hubbellc/Oscillating-Air-Engine/Engine Complete.jpg

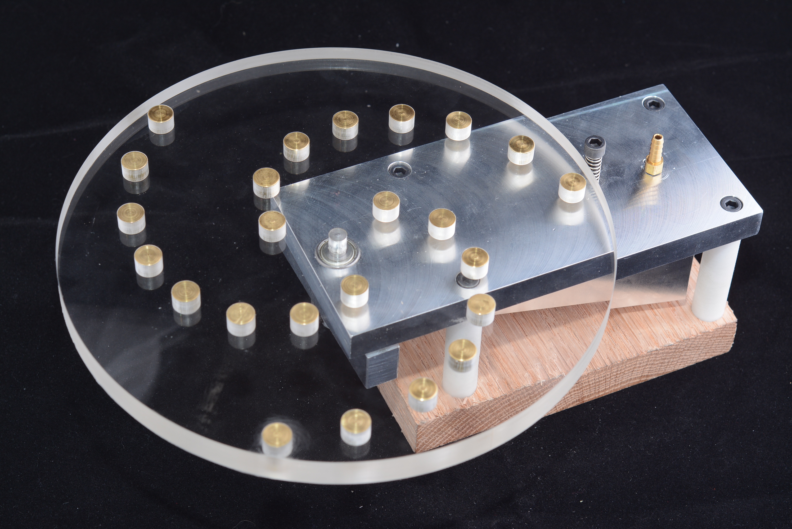
Engine Complete.jpg
