hubbellc/Oscillating-Air-Engine/Engine Facts.pdf

# The Enterprise – By Caleb Hubbell

# Facts Sheet

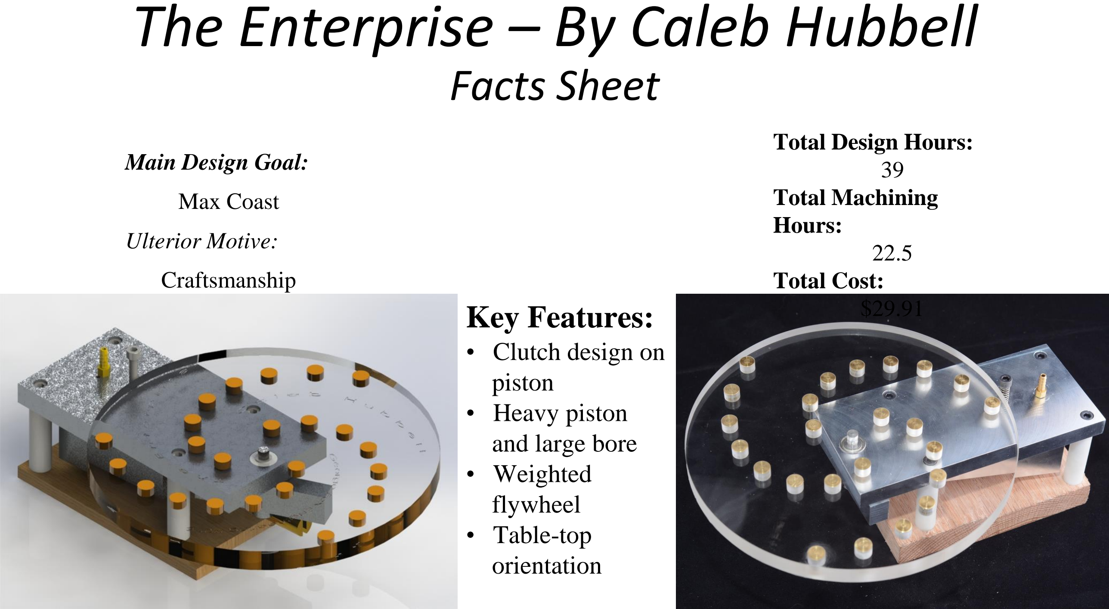
[picture p3: page 1]

Main Design Goal:

Max Coast

Ulterior Motive:

Craftsmanship

## Key Features:

- Clutch design on
piston
- Heavy piston
and large bore
- Weighted
flywheel
- Table-top
orientation

Total Design Hours:
39
Total Machining
Hours:
22.5
Total Cost:
$29.91
