hubbellc/Oscillating-Air-Engine/Engine Comp.jpg

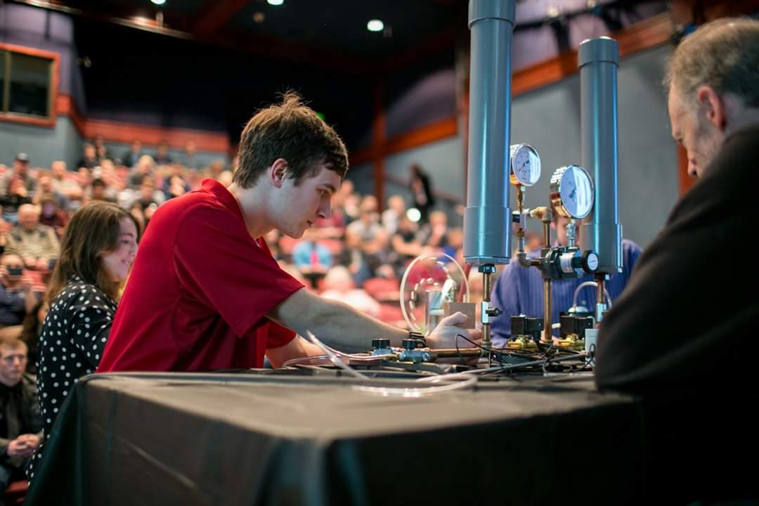
Engine Comp.jpg
