hubbellc/Oscillating-Air-Engine/Engine Flywheel Cut.jpg

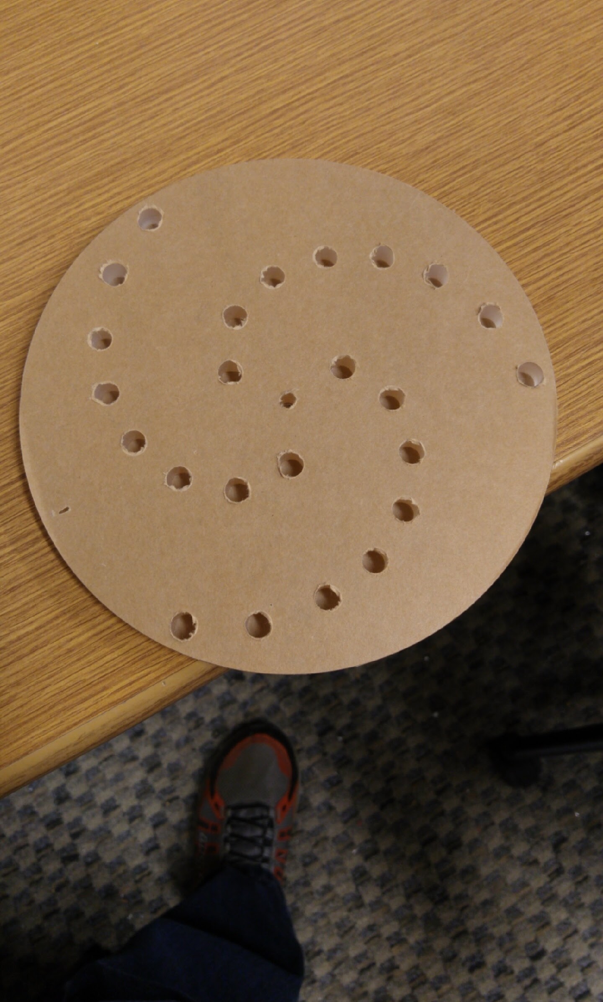
Engine Flywheel Cut.jpg
