hubbellc/Oscillating-Air-Engine/Engine Flywheel with Inserts.jpg

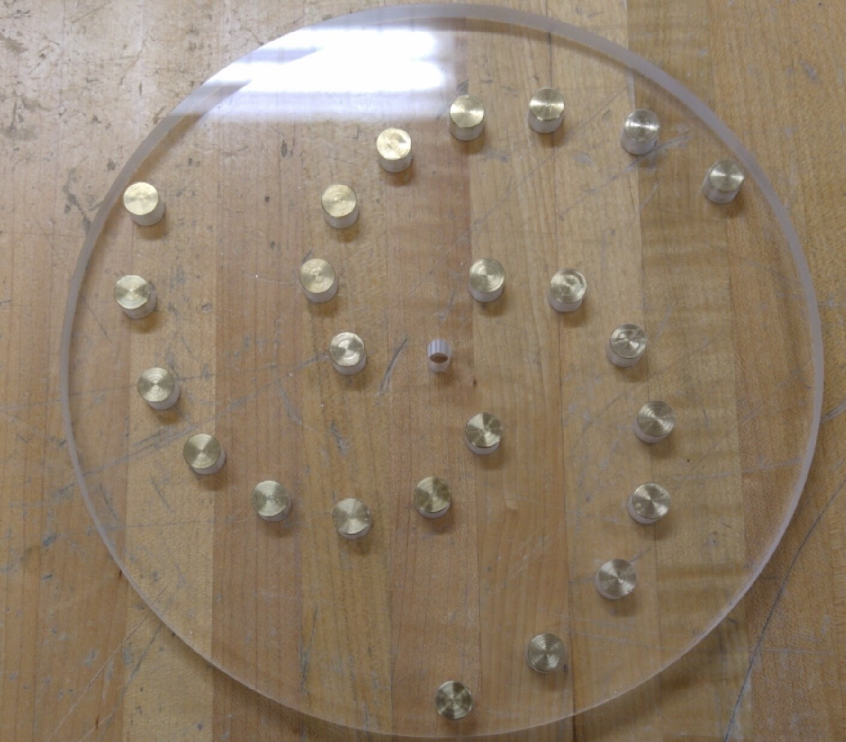
Engine Flywheel with Inserts.jpg
