hubbellc/Oscillating-Air-Engine/Engine Progress.jpg

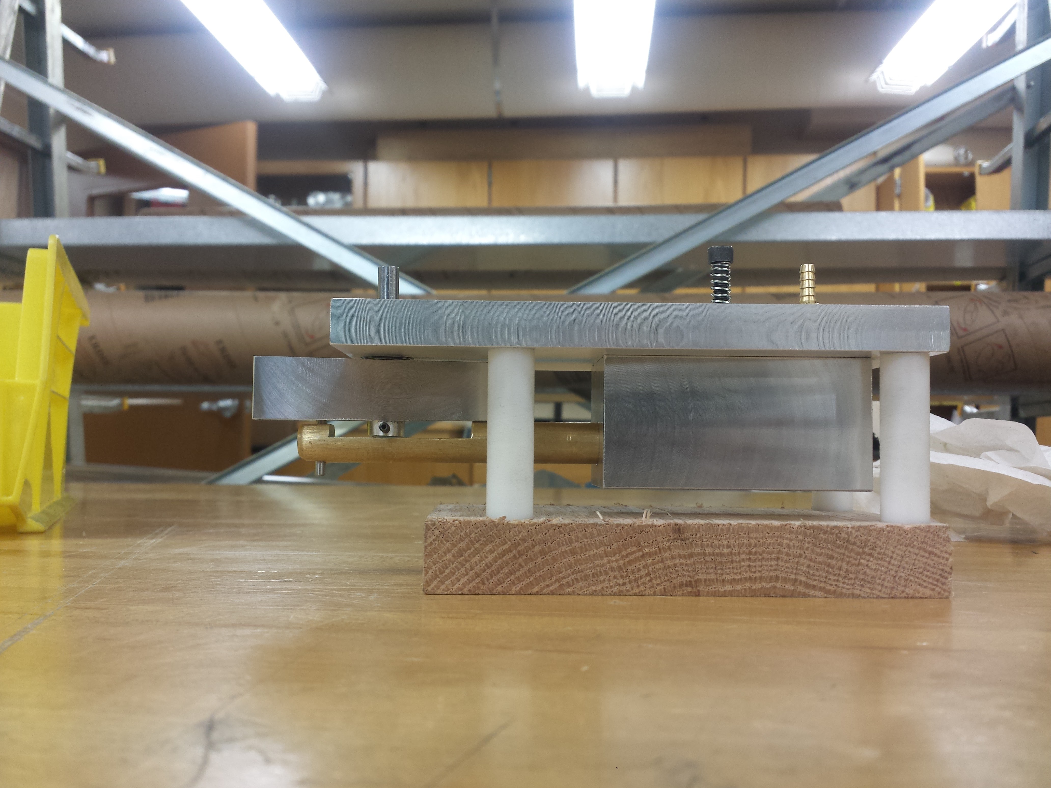
Engine Progress.jpg
