hubbellc/Oscillating-Air-Engine/Engine Bill of Materials.xlsx

 |  |  | Caleb Hubbell
 | Part Description | Stock Demension | Material | Added Length (in inches) | Cost per Unit | Quantity | Cost
1 | Legs | 1/2" | White Delrin | 2 | $0.12 | 4 | $0.96
2 | Valve Plate | ½” x 3” | Aluminum | 6.5 | $1.03 | 1 | $6.70
3 | Cylinder | 1 1/2" x 1 1/2" | Aluminum | 3 | $1.00 | 1 | $3.00
4 | Piston | 1/2” | Brass | 4.5 | $0.62 | 1 | $2.79
5 | Crank "Disc" | 1/2"x 3" | Aluminum | 0.9 | $1.03 | 1 | $0.93
6 | Crank Shaft | 1/4" | Steel | 1.952 | $0.31 | 1 | $0.61
7 | Flywheel | 1/2" | Clear Acrylic | 7.75^2 | $0.06 | 1 | $3.60
8 | Inserts | 3/8" | Brass | 0.445 | $0.38 | 24 | $4.06
9 | Base Plate | 1"x 5.5" | Oak | 3 | $0.30 | 1 | $0.90
 |  |  |  |  |  | Machined Total: | $23.54
10 | Air Inlet | 10-32 Thread |  |  | $0.96 | 1 | $0.96
11 | Bearings |  |  |  | $1.49 | 2 | $2.98
12 | Spring | 1"x.24" |  |  | $0.82 | 1 | $0.82
13 | Leg Screws | #10-32 1" |  |  | $0.16 | 4 | $0.64
14 | Cylindar Screw | #10-32 2" |  |  | $0.25 | 1 | $0.25
15 | Shim | .03 1/4in |  |  | $0.17 | 2 | $0.34
16 | Set Screw | #4-40 3/8" |  |  | $0.13 | 1 | $0.13
17 | E-Pin | 1/8" |  | 1 | $0.25 | 1 | $0.25
 |  |  |  |  |  | Purchased Total: | $6.37
 |  |  |  |  |  | Total Cost: | $29.91
