hubbellc/Oscillating-Air-Engine/Engine Design Files/Engine Take 1.SLDASM

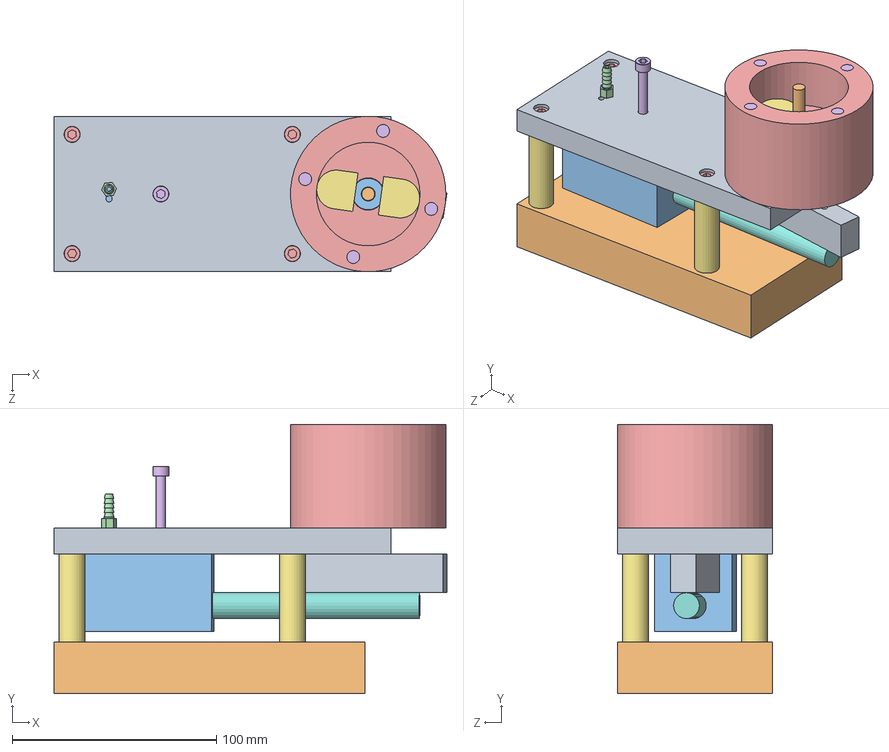
[picture p8: CAD file, 2018-04-09]
Engine Design Files/Engine Take 1.SLDASM
192.6 x 132.1 x 76.2 mm
Crank Disk
Crank Shaft
Cylindar
E-Pin
Flywheel
Inserts x 4
Legs x 4
Piston
Valve Plate
Base Plate
Ball_Bearing x 2
Barbed_Air_Inlet
SHCS_#10_x_1000 x 4
SHCS_#10_x_2000
Clutch's x 2
