hubbellc/Oscillating-Air-Engine/Engine Design Files/Engine.SLDASM

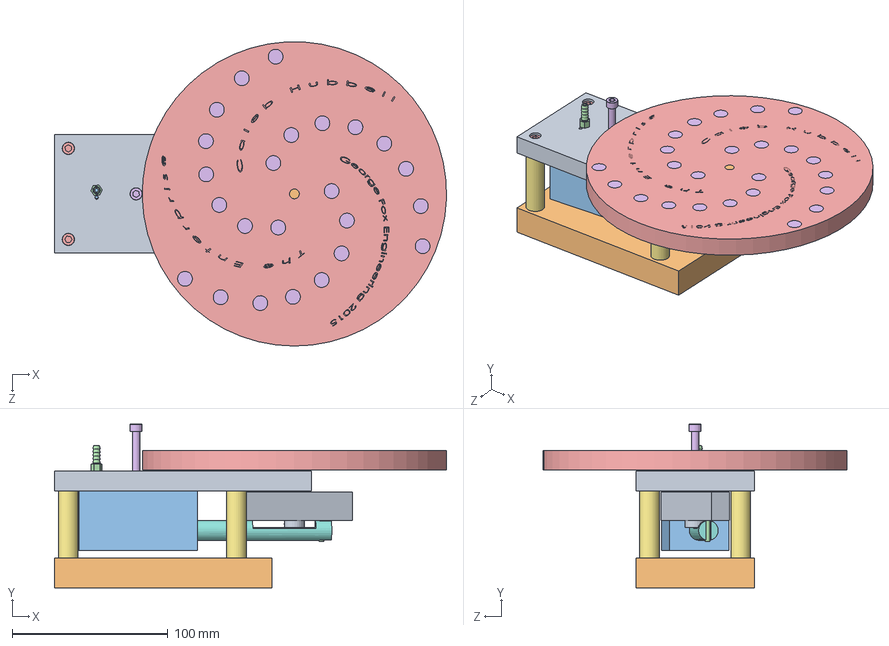
[picture p9: CAD file, 2018-04-09]
Engine Design Files/Engine.SLDASM
251.6 x 105.1 x 195.2 mm
Crank Disk
Crank Shaft
Cylindar
E-Pin
Flywheel
Inserts x 24
Legs x 4
Piston
Valve Plate
Base Plate
Ball_Bearing x 2
Barbed_Air_Inlet
SHCS_#10_x_1000 x 4
SHCS_#10_x_2000
Shim_0_030 x 2
Set_Screw_#4_x_0375
