hubbellc/Oscillating-Air-Engine/Engine Design Files/Flywheel.SLDPRT

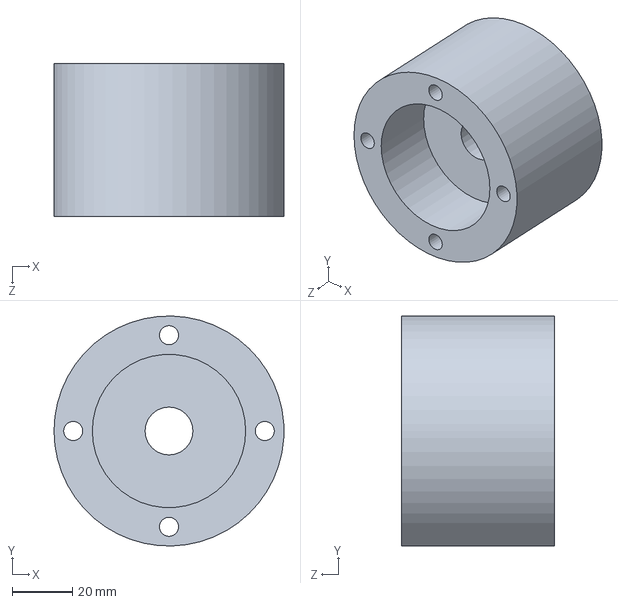
[picture p10: CAD file, 2018-04-09]
Engine Design Files/Flywheel.SLDPRT
76.2 x 76.2 x 50.8 mm
