hubbellc/Oscillating-Air-Engine/Engine Design Files/Inserts.SLDPRT

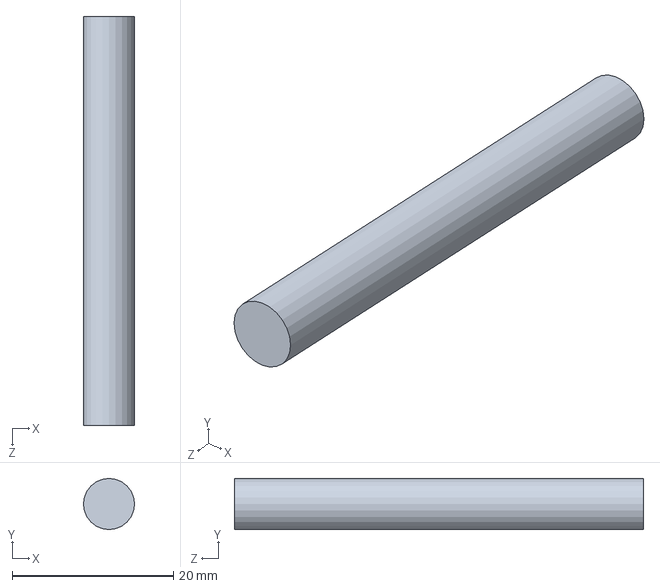
[picture p11: CAD file, 2018-04-09]
Engine Design Files/Inserts.SLDPRT
6.35 x 6.35 x 50.8 mm
