hubbellc/Oscillating-Air-Engine/Engine Design Files/Valve Plate.SLDPRT

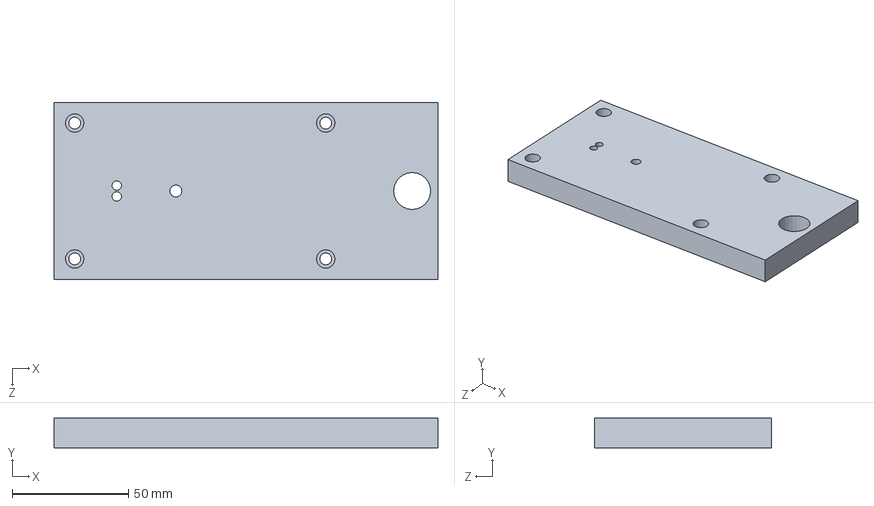
[picture p12: CAD file, 2018-04-09]
Engine Design Files/Valve Plate.SLDPRT
165.1 x 12.7 x 76.2 mm
