hubbellc/Oscillating-Air-Engine/Engine Design Files/E-Pin.SLDPRT

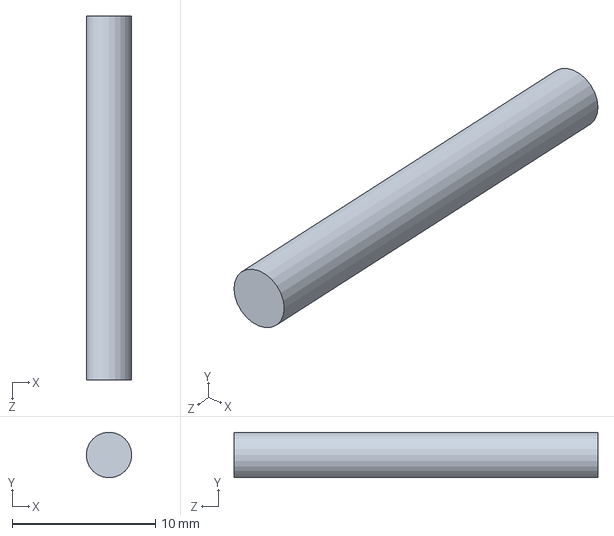
[picture p13: CAD file, 2018-04-09]
Engine Design Files/E-Pin.SLDPRT
3.18 x 3.18 x 25.4 mm
