hubbellc/Oscillating-Air-Engine/Engine Design Files/Base Plate.SLDPRT

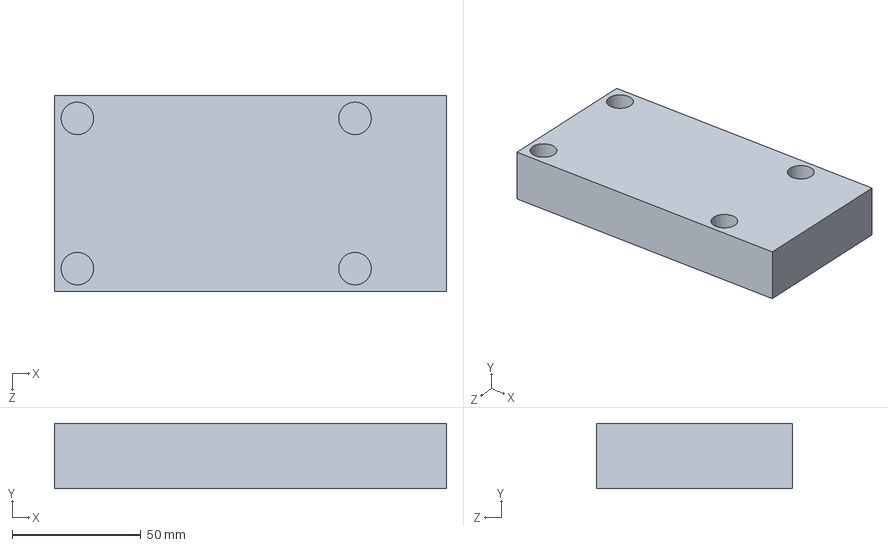
[picture p14: CAD file, 2018-04-09]
Engine Design Files/Base Plate.SLDPRT
152.4 x 25.4 x 76.2 mm
