hubbellc/Oscillating-Air-Engine/Engine Design Files/Crank Disk.SLDPRT

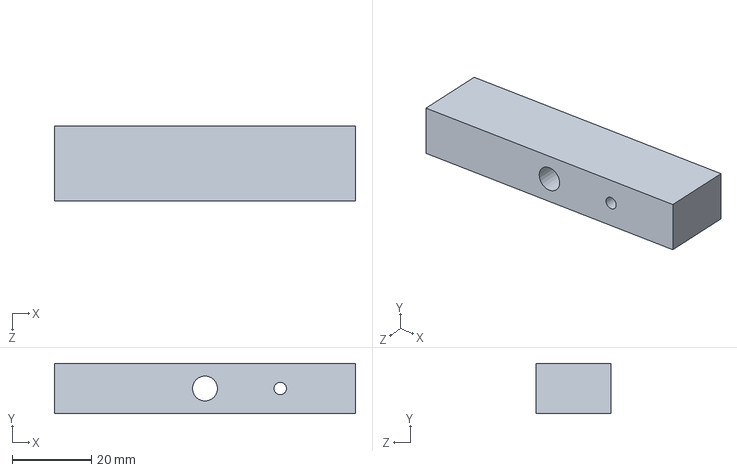
[picture p15: CAD file, 2018-04-09]
Engine Design Files/Crank Disk.SLDPRT
76.2 x 12.7 x 19.1 mm
