hubbellc/Oscillating-Air-Engine/Engine Design Files/Piston.SLDPRT

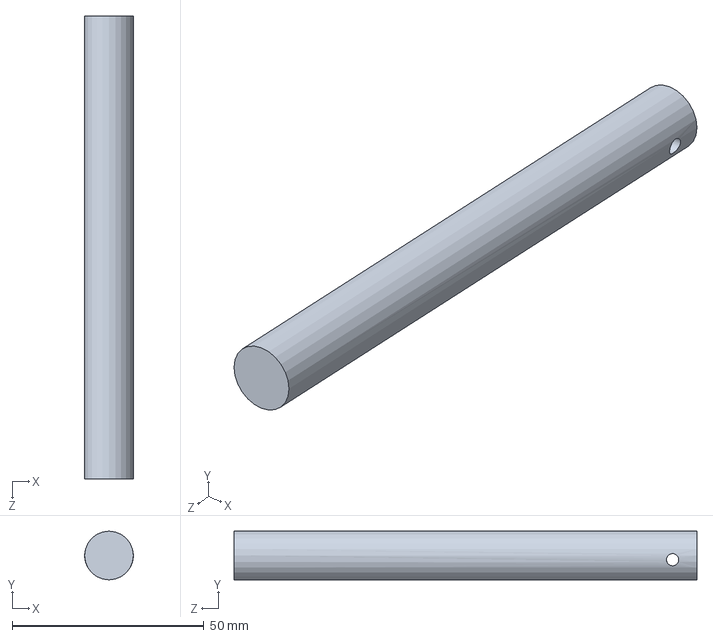
[picture p16: CAD file, 2018-04-09]
Engine Design Files/Piston.SLDPRT
12.7 x 12.7 x 120.7 mm
