hubbellc/Oscillating-Air-Engine/Engine Design Files/Clutch's.SLDPRT

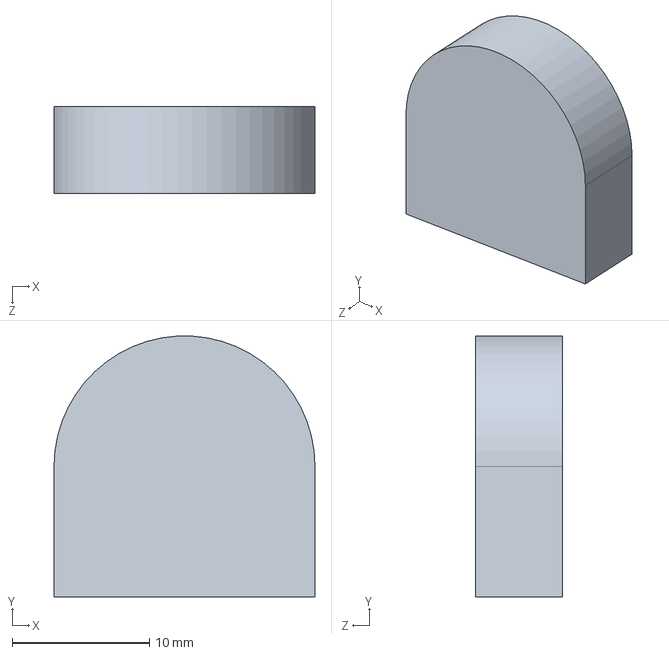
[picture p17: CAD file, 2018-04-09]
Engine Design Files/Clutch's.SLDPRT
19.1 x 19.0 x 6.35 mm
