hubbellc/Oscillating-Air-Engine/Engine Design Files/Crank Shaft.SLDPRT

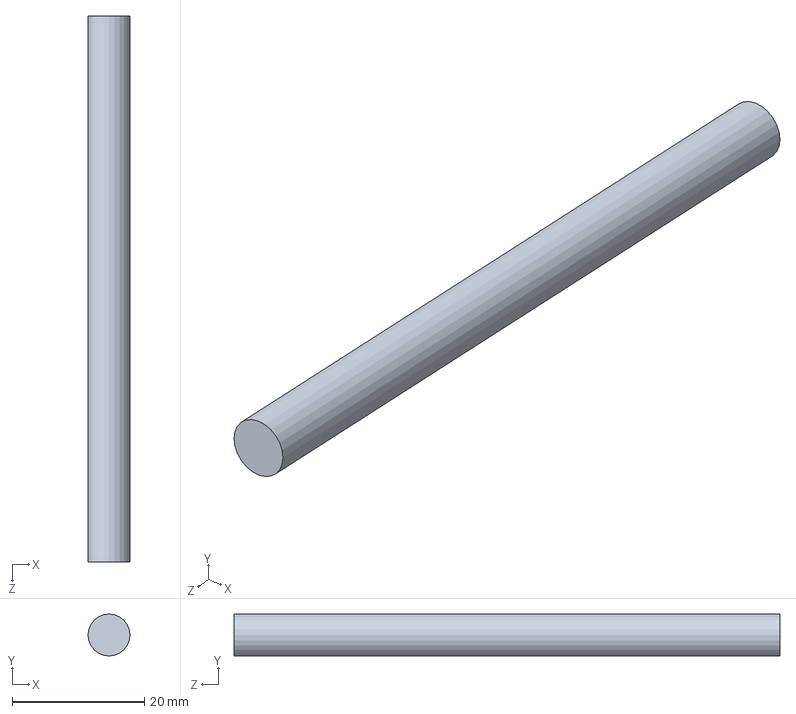
[picture p18: CAD file, 2018-04-09]
Engine Design Files/Crank Shaft.SLDPRT
6.35 x 6.35 x 82.5 mm
