hubbellc/Oscillating-Air-Engine/Engine Design Files/Legs.SLDPRT

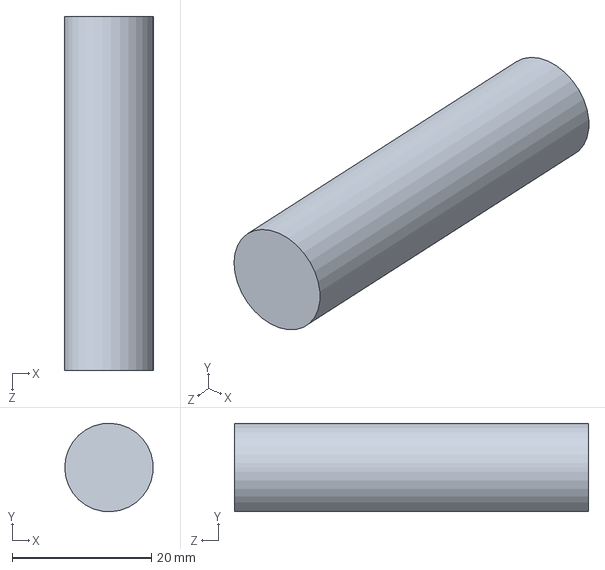
[picture p19: CAD file, 2018-04-09]
Engine Design Files/Legs.SLDPRT
12.7 x 12.7 x 50.8 mm
