hubbellc/Oscillating-Air-Engine/Engine Design Files/Cylindar.SLDPRT

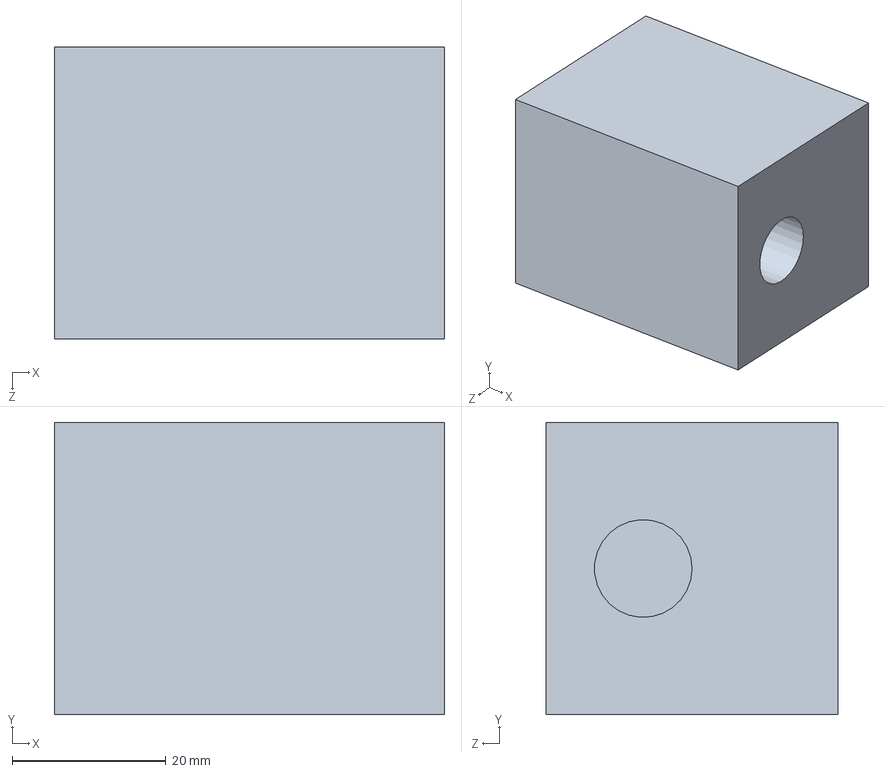
[picture p20: CAD file, 2018-04-09]
Engine Design Files/Cylindar.SLDPRT
50.8 x 38.1 x 38.1 mm
