hubbellc/Oscillating-Air-Engine/(list of files, cad)

Other CAD files:
Engine Design Files/Engine Run 1.SLDASM
Engine Design Files/Base Plate.SLDDRW
Engine Design Files/Cover Sheet.SLDDRW
Engine Design Files/Crank Disk.SLDDRW
Engine Design Files/Crank Shaft.SLDDRW
Engine Design Files/Cylindar.SLDDRW
Engine Design Files/Engine Exploded.SLDDRW
Engine Design Files/Engine Simple.SLDDRW
Engine Design Files/Flywheel.SLDDRW
Engine Design Files/Inserts.SLDDRW
Engine Design Files/Legs.SLDDRW
Engine Design Files/Piston.SLDDRW
Engine Design Files/Valve Plate.SLDDRW
