hubbellc/Oscillating-Air-Engine/Engine Presentation.jpg

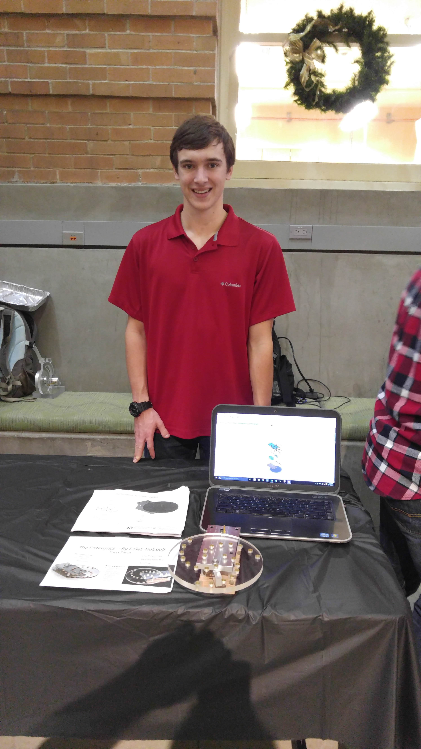
Engine Presentation.jpg
